Poofjunior/imu_noodle/pcbs/imu_noodle_node_v2/imu_noodle_rev-2.0_schematic_output.pdf

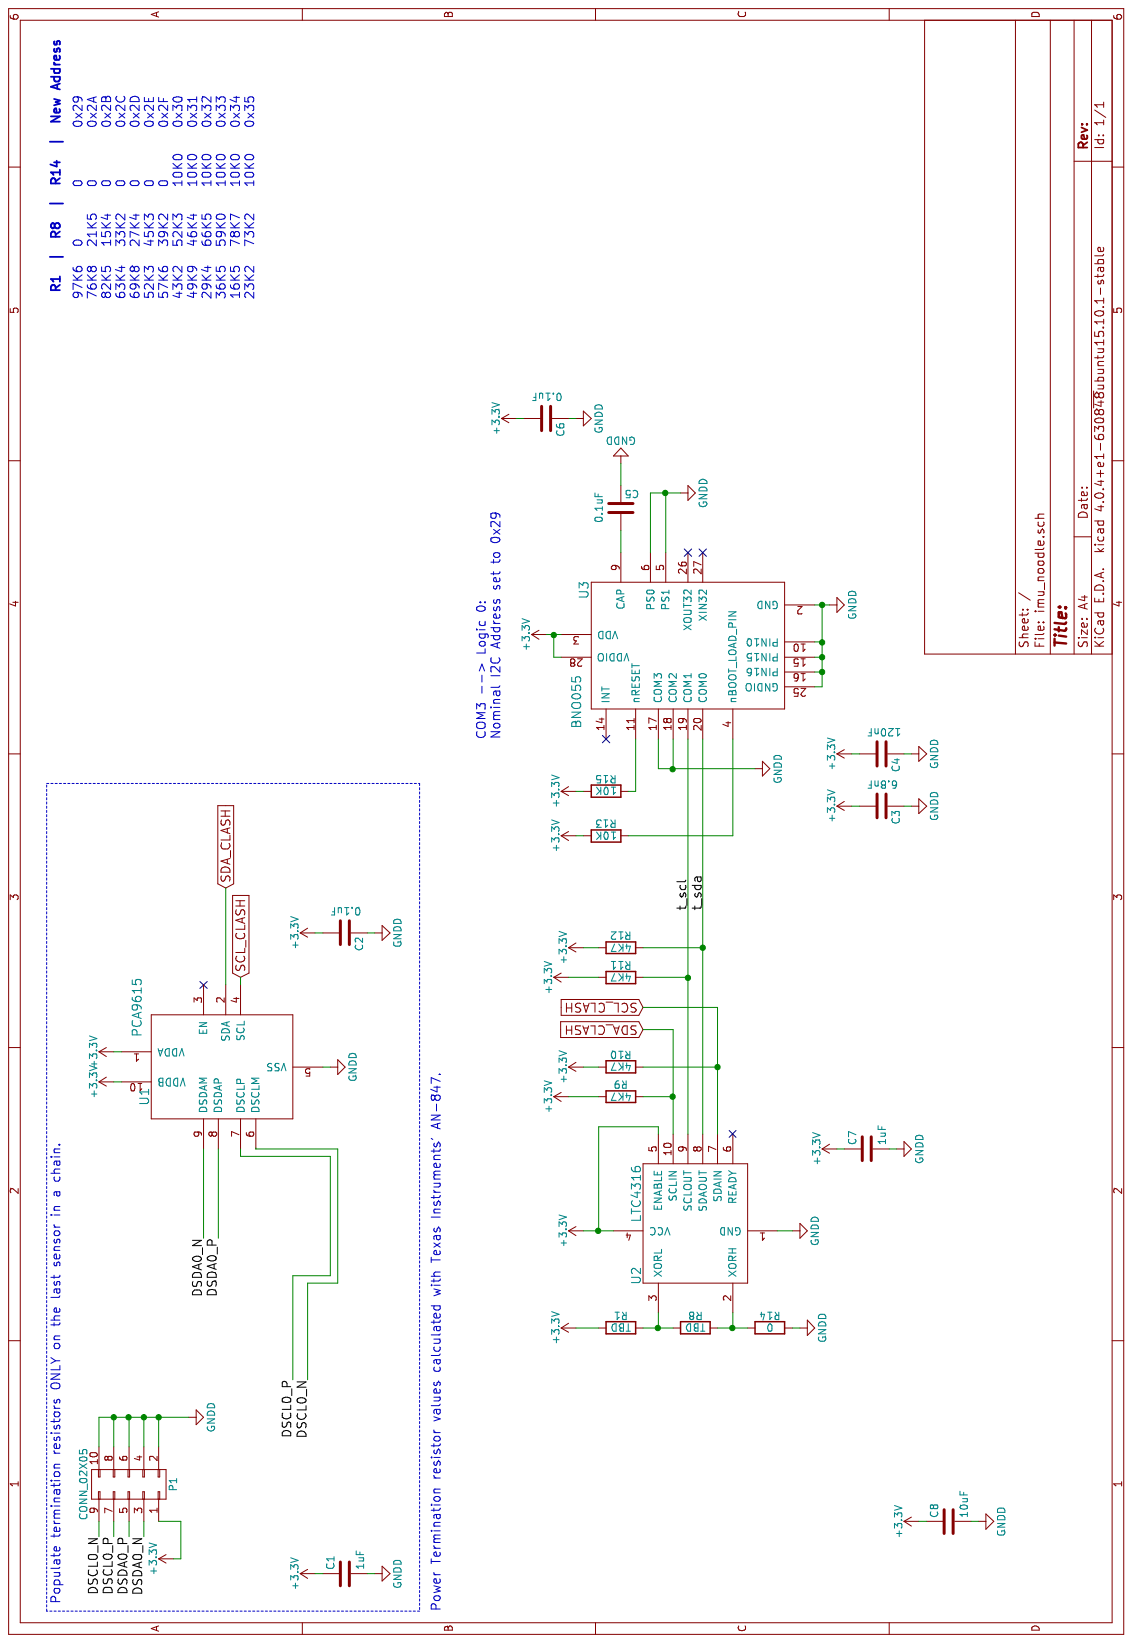
[picture p1: page 1]
