Poofjunior/imu_noodle/pcbs/imu_noodle_node_v1/imu_noodle_rev-1.1_schematic_output.pdf

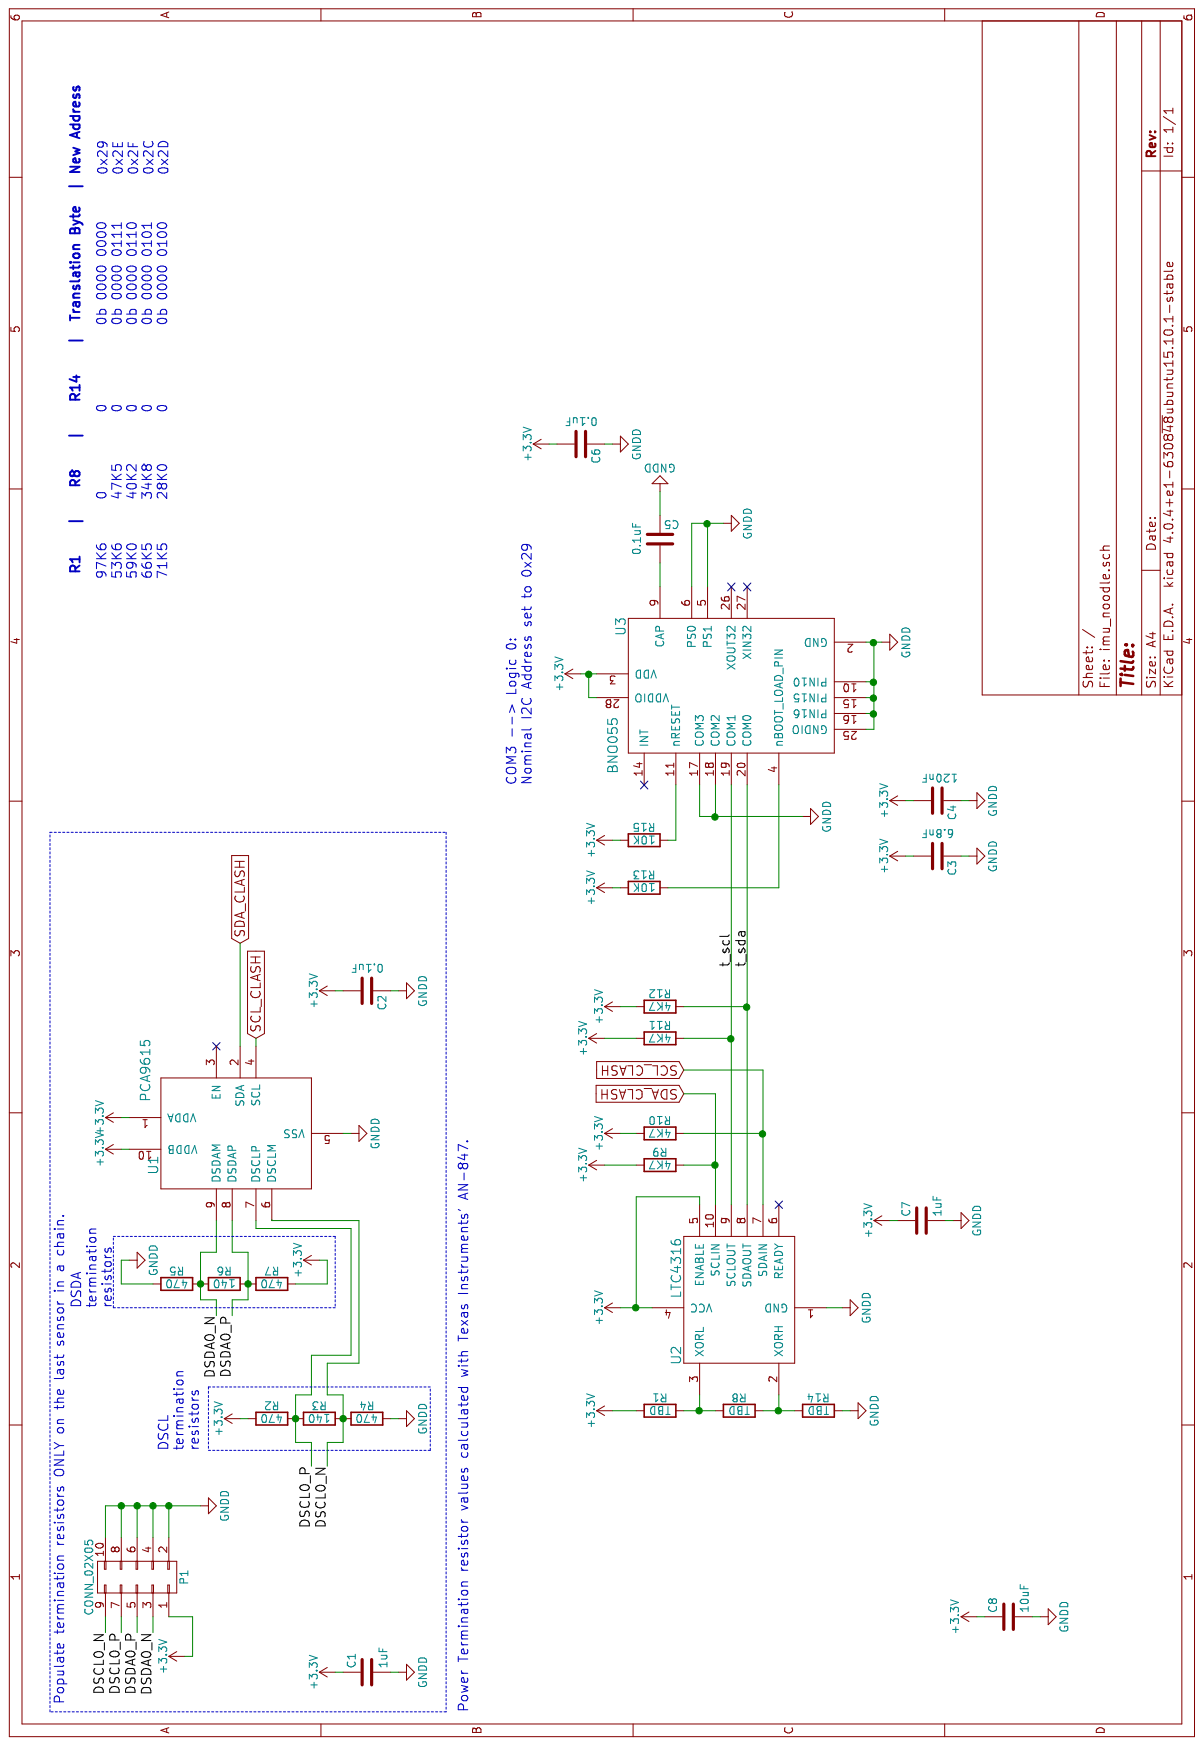
[picture p2: page 1]
