Poofjunior/imu_noodle/pcbs/imu_noodle_node_v2/imu_noodle.kicad_pcb

## KiCad design pcbs/imu_noodle_node_v2/imu_noodle.kicad_pcb (2018-04-16)

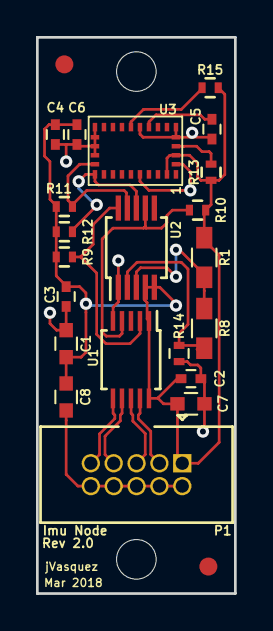
[picture p3: board imu_noodle.kicad_pcb from above]

Board: 2 copper layers, 11.0 x 30.9 mm, 21 parts (0 on the bottom side), 15 nets.

Parts:
C1, C7: 1uF; C_0603
C2, C5, C6: 0.1uF; C_0402
C3: 6.8nF; C_0402
C4: 120nF; C_0402
C8: 10uF; C_0603
P1: CONN_02X05; 3M_ribbon_connector_thru_5x2_.05in_pitch_45210-620230
R1, R8: TBD; R_0603_HandSoldering
R9, R10, R11, R12: 4K7; R_0402
R13, R15: 10K; R_0402
R14: 0; R_0402
U1: PCA9615; TSSOP-10_3x3mm_Pitch0.5mm
U2: LTC4316; MSOP-10_3x3mm_Pitch0.5mm
U3: BNO055; LGA-28

Connections:
+3V3: C1.1, C2.2, C3.2, C4.2, C6.2, C7.1, C8.1, P1.1, R1.1, R9.1, R10.1, R11.1, R12.1, R13.1, R15.1, U1.1, U1.10, U2.4, U2.5, U3.3, U3.28
/DSCL0_N: P1.9, U1.6
/DSCL0_P: P1.7, U1.7
/DSDA0_N: P1.3, U1.9
/DSDA0_P: P1.5, U1.8
/t_scl: R11.2, U2.9, U3.19
/t_sda: R12.2, U2.8, U3.20
GNDD: C1.2, C2.1, C3.1, C4.1, C5.1, C6.1, C7.2, C8.2, P1.2, P1.4, P1.6, P1.8, P1.10, R14.2, U1.5, U2.1, U3.2, U3.5, U3.6, U3.10, U3.15, U3.16, U3.17, U3.18, U3.25
unnamed: C5.2, U3.9
unnamed: R1.2, R8.1, U2.3
unnamed: R13.2, U3.4
unnamed: R8.2, R14.1, U2.2
unnamed: R15.2, U3.11
SCL_CLASH: R10.2, U1.4, U2.7
SDA_CLASH: R9.2, U1.2, U2.10
