Poofjunior/imu_noodle/pcbs/di2c_breakout/di2c_breakout.kicad_pcb

## KiCad design pcbs/di2c_breakout/di2c_breakout.kicad_pcb (2017-03-24)

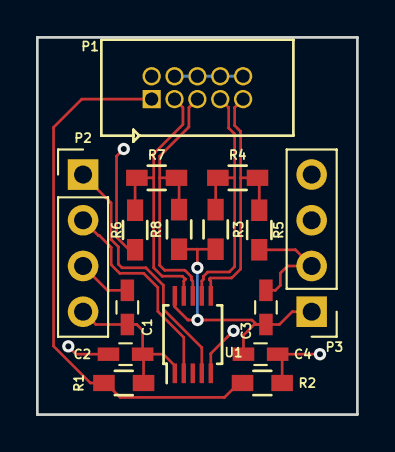
[picture p4: board di2c_breakout.kicad_pcb from above]

Board: 2 copper layers, 17.8 x 21.0 mm, 16 parts (0 on the bottom side), 10 nets.

Parts:
C1, C3: 1uF; C_0603_HandSoldering
C2, C4: 0.1uF; C_0603_HandSoldering
P1: CONN_02X05; 3M_ribbon_connector_thru_5x2_.05in_pitch_45210-600230
P2, P3: CONN_01X04; Pin_Header_Straight_1x04_Pitch2.54mm
R1, R2: 0; R_0603_HandSoldering
R3, R4, R5: TBD; R_0603_HandSoldering
R6, R8: 750; R_0603_HandSoldering
R7: 130; R_0603_HandSoldering
U1: PCA9615; TSSOP-10_3x3mm_Pitch0.5mm

Connections:
/DSCL0_N: P1.9, R4.2, R5.1, U1.6
/DSCL0_P: P1.7, R3.2, R4.1, U1.7
/DSDA0_N: P1.3, R6.2, R7.1, U1.9
/DSDA0_P: P1.5, R7.2, R8.1, U1.8
/SCL: P2.1, U1.4
/SDA: P2.2, U1.2
GNDD: C1.2, C2.2, C3.2, C4.2, P1.2, P1.4, P1.6, P1.8, P1.10, P2.3, P3.2, P3.3, P3.4, R2.2, R5.2, R6.1, U1.5
unnamed: P1.1, R1.1, R2.1
VDDA: C1.1, C2.1, P2.4, R1.2, U1.1
VDDB: C3.1, C4.1, P3.1, R3.1, R8.2, U1.10
