Poofjunior/imu_noodle/(threads)

Thread 1 (2017-10-06):

missing libraries in .sch files

jvcleave, 2017-10-06:
When I open the .sch files in KiCad (Mac) I get this message:

The following libraries were not found:

/home/jvasquez/Projects/synthego_component_library/synthego_component_library

/home/jvasquez/Projects/double_jump_electric_component_library/double_jump_electric_component_library
