Poofjunior/imu_noodle/visualization/line_viz/src/node_usb_driver.h

#ifndef NODE_USB_H
#define NODE_USB_H
#include "qpose/src/quaternion.hpp"
#include <usb_packet.h>
#include <libusb-1.0/libusb.h>
#include <iostream>
#include <cstring>

class NodeUsbDriver
{
 public:

    NodeUsbDriver();

    ~NodeUsbDriver();

    void updateNodes();

    libusb_device_handle* devHandle_;
    libusb_context* ctx_;

    static const size_t NUM_NODES = 5;  // total number of nodes
    static const size_t NUM_BYTES = 64; // teensy bulk transfer size.

    /// The angles of each imu node.
    Quaternion<float> orientations_[NUM_NODES];

private:
    static const uint16_t TEENSY_VID = 0x16C0;
    static const uint16_t TEENSY_PID = 0x0486;

    USBPacket usbPacket_;
};
#endif //NODE_USB_H
