Poofjunior/imu_noodle/(commit log)

2017-01-31 added imu noodle nodes and di2c breakout
    [di2c_breakout.kicad_pcb, di2c_breakout.sch, imu_noodle.kicad_pcb, imu_noodle.sch]
2017-01-31 flipping silkscreen
    [di2c_breakout.kicad_pcb]
2017-02-02 added more caps; specified BOM components; finished first pass at layout
    [di2c_breakout.sch, imu_noodle.kicad_pcb, imu_noodle.sch]
2017-02-02 finished node layout; passes drc
    [imu_noodle.kicad_pcb, imu_noodle.sch]
2017-02-02 finished node sch and pcb; passes drc
    [imu_noodle.kicad_pcb, imu_noodle.sch]
2017-03-24 added beginnings of a bno055 driver
    [di2c_breakout.kicad_pcb, imu_noodle.kicad_pcb, imu_noodle.sch]
2017-03-25 fixed byte order bug
    [multi_node_bringup.ino]
2017-05-14 added translation byte docs to schematic
    [imu_noodle.sch]
2017-05-14 added pdf of schematic
2018-04-16 added imu v2 node
    [imu_noodle.kicad_pcb, imu_noodle.sch]
2018-04-25 adding v2 schematic
    [imu_noodle.sch]
